BernardoVilaca/LiteCOPASAelevatoria/Testes&Resultados/FLUXOGRAMA_AUTOGERENCIAMENTO_ELEVATÓRIA.jpg

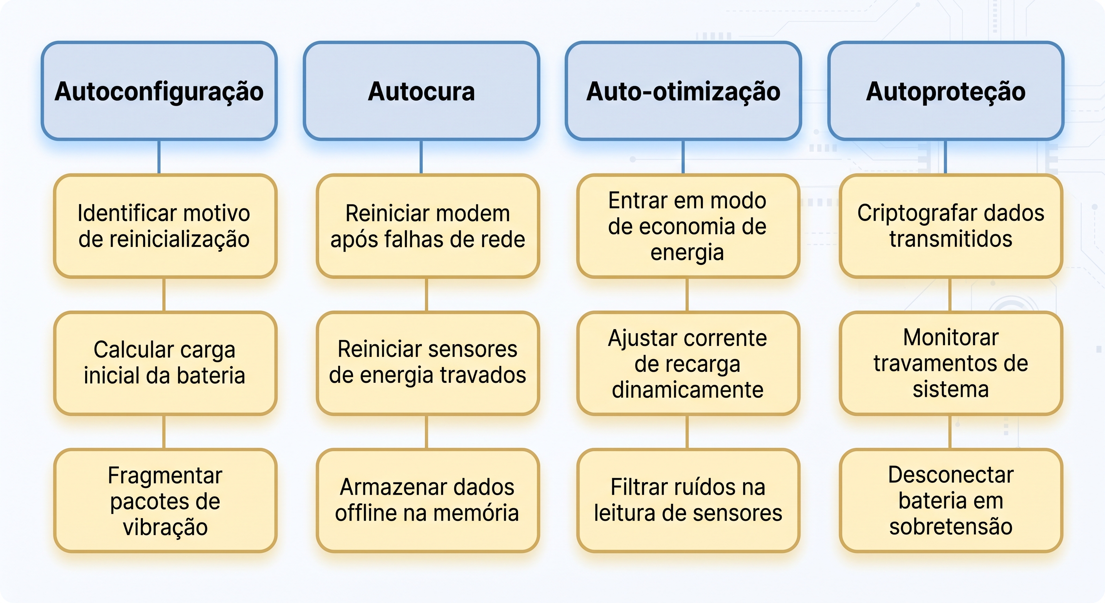
Testes&Resultados/FLUXOGRAMA_AUTOGERENCIAMENTO_ELEVATÓRIA.jpg
