BernardoVilaca/LiteCOPASAelevatoria/FonteCorrente_Para4a20Para0a3v3/CircuitoPressaoCopasaDesenhoBernardos.jpg

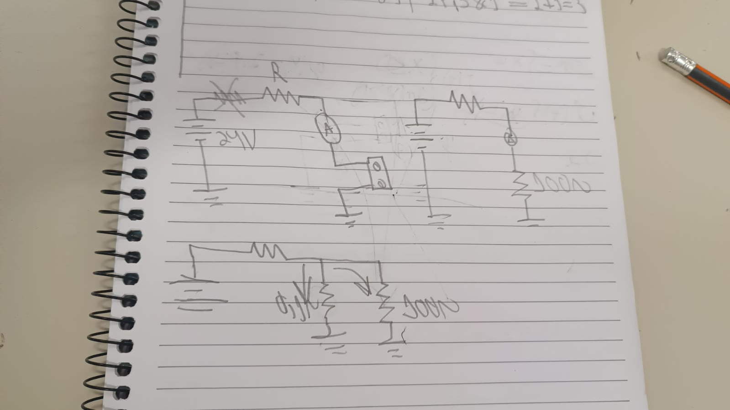
FonteCorrente_Para4a20Para0a3v3/CircuitoPressaoCopasaDesenhoBernardos.jpg
