BernardoVilaca/LiteCOPASAelevatoria/ReferênciasInternasLITE/Lab - Introdução_Metrologia_ESP32_2025.docx

Laboratório – Introdução à Metrologia Elétrica com o módulo potenciômetro e o ESP32

# Objetivos

Uso do Software Arduino IDE

Configuração do ESP32 no Arduino IDE

# Executar os procedimentos de metrologia elétrica com o módulo potenciômetro e o ESP32

# Histórico/Cenário

Os sensores que serão utilizados no projeto de desenvolvimento tecnológico devem apresentar medidas confiáveis, de modo que a base de dados gerada pelo sistema projetado possibilite a extração de conhecimento da planta também confiável! Nesta atividade, você executará os procedimentos de metrologia elétrica utilizando o módulo potenciômetro e o ESP32.

# Recursos necessários

- ESP32
- Um cabo USB para conexão ao PC
- Módulo potenciômetro de 10 kOhm
- Multímetro Fluke

# Estudo dos principais conceitos em metrologia elétrica para execução de correção de medidas elétricas

Etapa 1: Principais conceitos em metrologia elétrica

a. Descrição dos principais conceitos de metrologia elétrica disponíveis nas notas de aula em anexo (Fonte: PUC Goiás e o livro “Fundamentos de Metrologia Científica e Industrial”):
  1) Medir:
  2) Mensurando:
  3) Instrumento de medição:
  4) Indicação da medida:
  5) Indicação direta da medida e dê um exemplo:
  6) Processo de medição:
  7) Resultado da medição, sua equação e um exemplo numérico com uma régua:
  8) Resultado base:
  9) Incerteza da medição:
  10) Incerteza de medição do conversor A/D do ESP32:
b. Definição de erro sistemático, erro aleatório, tendência, correção e outros termos:
  1) Erro de medição e sua equação:
  2) Fontes de erros de medição:
  3) Erro sistemático e um exemplo:
  4) Erro aleatório e um exemplo:
  5) Exatidão:
  6) Precisão:
  7) Equação do erro sistemático:
  8) Tendência e sua equação:
  9) Correção e sua equação:
  10) Valor verdadeiro convencional:
  11) Indicação corrigida:
  12) Equação do erro aleatório:
  13) Repetitividade e sua equação para um número finito de amostras:
  14) Diferença entre erro e incerteza de medição:

Etapa 2: Cálculo de tendência e correção das medidas de tensão elétrica com o módulo potenciômetro e o ESP32

a. Definição do medidor de referência (especificações técnicas metrológicas do datasheet do multímetro Fluke) para a medição de tensão elétrica no módulo potenciômetro

R.

b. Utilize a prática “Lab - Introduction to Arduino_ADC_2025” e siga os procedimentos a seguir para realizar a correção das medidas de tensão realizadas na referida prática.
  1) Cálculo da tendência para as medidas da tabela da prática. Apresente as tabelas de medidas, conforme exemplo disponível na aula 2 em anexo. Cole a tela do monitor serial para cada uma das medidas de tensão do ESP32 (uma tela por tabela).

Valor ajustado no potenciômetro e medido com o Voltímetro (V) | Valor calculado pelo programa (Vax) [V]
0,50 V
0,50 V
0,50 V
0,50 V
0,50 V
0,50 V
0,50 V
0,50 V
0,50 V
0,50 V
0,50 V
0,50 V
Média:
Desvio-padrão:
Tendência (Td = I – VVC):
Correção (C):

Valor ajustado no potenciômetro e medido com o Voltímetro (V) | Valor calculado pelo programa (Vax) [V]
1,00 V
1,00 V
1,00 V
1,00 V
1,00 V
1,00 V
1,00 V
1,00 V
1,00 V
1,00 V
1,00 V
1,00 V
Média:
Desvio-padrão:
Tendência (Td = I – VVC):
Correção (C):

Valor ajustado no potenciômetro e medido com o Voltímetro (V) | Valor calculado pelo programa (Vax) [V]
1,50 V
1,50 V
1,50 V
1,50 V
1,50 V
1,50 V
1,50 V
1,50 V
1,50 V
1,50 V
1,50 V
1,50 V
Média:
Desvio-padrão:
Tendência (Td = I – VVC):
Correção (C):

Valor ajustado no potenciômetro e medido com o Voltímetro (V) | Valor calculado pelo programa (Vax) [V]
2,00 V
2,00 V
2,00 V
2,00 V
2,00 V
2,00 V
2,00 V
2,00 V
2,00 V
2,00 V
2,00 V
2,00 V
Média:
Desvio-padrão:
Tendência (Td = I – VVC):
Correção (C):

Valor ajustado no potenciômetro e medido com o Voltímetro (V) | Valor calculado pelo programa (Vax) [V]
2,50 V
2,50 V
2,50 V
2,50 V
2,50 V
2,50 V
2,50 V
2,50 V
2,50 V
2,50 V
2,50 V
2,50 V
Média:
Desvio-padrão:
Tendência (Td = I – VVC):
Correção (C):

Valor ajustado no potenciômetro e medido com o Voltímetro (V) | Valor calculado pelo programa (Vax) [V]
3,00 V
3,00 V
3,00 V
3,00 V
3,00 V
3,00 V
3,00 V
3,00 V
3,00 V
3,00 V
3,00 V
3,00 V
Média:
Desvio-padrão:
Tendência (Td = I – VVC):
Correção (C):

É possível fazer uma única correção para todos os valores medidos?

R.

  2) Cálculo da correção a ser inserida no programa de computador da prática.

R.

  3) Cálculo da estimativa da repetitividade (número finito de amostras) para 95,45% de probabilidade (Re = t.u).

R. v = ; t = ; u = ; Re = ; Faixa de valores = .

  4) Código Arduino da prática atualizado com a correção. Não se esqueça de comentar o código! Lembre-se: Código bonito é código comentado!!! Apresente o resultado ao monitor/professor!

R.

  5) Atualize o fluxograma da prática no drawio e cole-o aqui. Baixe o arquivo drawio, pois você deverá anexá-lo na NetAcad.

R.

© terça-feira, 22 de outubro de 2018 18:27:39 Cisco e/ou suas afiliadas. Todos os direitos reservados. Este documento contém informações públicas da Cisco. Página 2 de 6
