BernardoVilaca/LiteCOPASAelevatoria/ReferênciasInternasLITE/lab_-_levantamento_como_construído_caracterização_eletromagnética_2025.docx

Laboratório – Levantamento de “como construído” e caracterização eletromagnética utilizando o ESP32

# Objetivos

Uso do Software Arduino IDE

Configuração do ESP32 no Arduino IDE

# Levantamento de “como construído” e caracterização eletromagnética utilizando o ESP32

# Histórico/Cenário

O projeto de soluções de IoT demanda uma ou mais visitas técnicas à planta alvo com o intuito de realizar o levantamento do “como construído” e a caracterização eletromagnética da referida planta. Nesta atividade, faremos uma aula de campo na estufa do COLTEC, para realizar essas atividades importantes da fase de projeto.

# Recursos necessários

- ESP32
- Um cabo USB para conexão ao Notebook
- Instalação do aplicativo Cobertura no Smartphone
- Instalação do aplicativo InSSIDer no Notebook, se for o caso.

Instalação do Aplicativo Cobertura no Smartphone.

Acesse o Google Play e procure o aplicativo Cobertura e, em seguida, instale-o em seu smartphone.

Instalação do Aplicativo InSSIDer no notebook.

Acesse o link InSSIDer (https://www.metageek.com/downloads/inssider-win/), baixe o aplicativo InSSIDer e instale-o em seu notebook. Se preferir, o notebook do professor poderá ser utilizado.

Uso do Software Arduino IDE.

Nessa parte, você conectará a placa de desenvolvimento do ESP32 ao computador por meio da porta USB. Você usará um programa de exemplo para medir o RSSI (Indicador de Intensidade do Sinal Recebido) de uma rede de Wi-Fi do COLTEC.

# Etapa 1: Noções de modulação, ruído, decibel e aplicações práticas da Série de Fourier

1. Cite e defina cada um dos parâmetros de uma portadora senoidal que podem ser modificados pelo sinal modulante.

R.

2. Cite as vantagens de se utilizar a modulação?

R.

3. Defina ruído.

R.

4. Defina SNR. Apresente sua equação.

R

5. Determine a capacidade máxima de um canal telefônico de largura de banda de 4 kHz e SNR de 30 dB.

R.

6. Defina decibel.

R.

7. Quais os principais motivos para a utilização do decibel?

R.

8. Mostre as equações para o cálculo em decibéis para tensão e potência.

R.

9. Cite as regras básicas de operação com decibéis.

R.

10. O que diz a Série de Fourier e quais as consequências práticas?

R.

11. Defina espectro e forma de onda.

R.

12. Calcular o ganho, em dB, de um amplificador, que excitado com 1 W de sinal na entrada fornece 10 W na saída.

R.

13. Converter 13 dBW em dBm e dBμ.

R.

14. Converter 30 dBm em dBW e dBμ.

R.

15. Converter 45 dBμ em dBW e dBm.

R.

16. Se o cálculo de tensão em dB tiver como referência a tensão de 1 volt, o resultado será expresso em dBV. Os valores de submúltiplos mili e micro também dão origem ao dBm e ao dBμ (similar ao caso da potência). Assim, converta 40 dBV em dBm e dBμ.

R.

17. Considerando-se a definição de dBV da questão anterior, para se converter 20 dBV em dBm, qual deve ser o valor a ser adicionado a 20 dBV? E para termos o resultado em dBμ?

R.

18. Calcular a diferença entre os níveis de potência: -110 dBm e –70 dBm.

R.

19. Dois sinais de 20 dBW dão entrada num circuito somador. Calcular o valor na saída.

R.

20. O nível de sinal na antena receptora é –53 dBm e o nível de ruído –73 dBm. Determine a SNR.

R.

# Etapa 2: Indicador da Intensidade do Sinal Recebido (RSSI, em inglês)

a. Consulte o que é, para que serve e qual é a unidade de medida do RSSI na Internet (Dica: aula de revisão sobre dB – Aula2_2029, na página principal do curso, módulo 3).
1) O que é o RSSI?

R.

2) Para que serve o RSSI?

R.

3) Qual é a unidade de medida do RSSI?

R.

b. O que é o dBm e como ele é calculado?
1) O que é o dBm?

R.

2) Como o dBm é calculado?

R.

c. Quanto vale (-30) dBm em unidade de potência (mW)?

R.

d. Explique a diferença entre -30 dBm e 30 dB?

R.

# Etapa 2: Conecte a placa Arduino

a. Inicie o Arduino IDE.
b. Vá em “Ferramentas” e verifique se a placa “ESP Dev Module” está selecionada.
c. Conecte o cabo USB à placa ESP32 e à porta USB no PC. Um LED vermelho fica aceso para indicar que ele está ligado.
d. Vá em “Ferramentas” e verifique se, na opção “Porta”, uma COM foi selecionada. Caso contrário, selecione a porta COM correta.

Etapa 3: Execute o código de exemplo.

a. Use o programa abaixo de exemplo:

#include <WiFi.h>

const char* ssid = "WIFI-LITE"; /*Replace SSID of your network "Team SAM"*/

const char* password = "LITE@IOT"; /*Replace with Password of your Network "123456789"*/

int counter = 1; /*Samples counter*/

const int samples = 30; /*Number of measures*/

const int timer = 1500; /*Time among samples*/

void setup() {

Serial.begin(115200); /*Baud Rate for serial communication*/

initWiFi(); /*Initialize WiFi*/

}

void loop() {

if (counter <= samples){

Serial.print("Connected Network Signal Strength (RSSI): ");

Serial.print(WiFi.RSSI()); /*Print WiFi signal strength*/

Serial.println(" dBm"); /*Power unit*/

delay(timer);

counter++;

} else{

Serial.println();

Serial.println("Finalizar medição!!!");

delay(5000);

}

}

void initWiFi() {

WiFi.mode(WIFI_STA); /*Initialize ESP32 WiFi in station mode*/

WiFi.begin(ssid, password); /*Begin WiFi connection*/

Serial.print("Connecting to WiFi ..");

while (WiFi.status() != WL_CONNECTED) {

Serial.print('.');

delay(1000);

}

Serial.println();

Serial.print("Local IP address of ESP32: ");

Serial.println(WiFi.localIP()); /*Print local IP address of ESP32*/

}

d. Explique o funcionamento desse programa?

R.

e. Para verificar se a placa correta foi selecionada, clique em Ferramentas > Placa. Ela deve ser ESP32 Dev Module.
f. Antes de compilar o programa, acrescente comentários às suas linhas, de modo que ele fique inteligível para outros programadores (lembre-se: código bonito é código comentado!).
g. Clique em Sketch > Verificar/Compilar para compilar o programa.
h. Clique em Sketch > Carregar para carregar o código compilado na sua placa.
i. Mostre o resultado ao monitor/professor.
j. Usando os conhecimentos que você adquiriu na prática “Lab - Creating a Process Flowchart”, faça o fluxograma do programa no Draw IO e cole-o aqui. Não se esqueça de salvar o arquivo DrawIO para postar posteriormente na NetAcad.

R.

k. Peça o SSID e a senha da rede Wi-Fi disponível na estufa, substitua no código anterior e grave-o no ESP32. Você está pronto para ir a campo!!!

Etapa 4: Relatório de atividades.

l. Descrição do "como construído" da estufa e do córrego. Descrever as características da planta (estufa) analisada (ilustre com fotos) e relate:
  a as demandas de sensoriamento e atuação (ilustre com fotos):

R.

  b melhores pontos de medição (ilustre com fotos):

R.

  c pontos de energia disponíveis (ilustre com fotos):

R.

  d necessidade ou não de instalação de infraestrutura para instalação do sistema de monitoramento (ilustre com fotos):

R.

m. Descrição da caracterização eletromagnética realizada na estufa.
  a Descrever as informações obtidas com o aplicativo cobertura e o programa InSSIDer (ilustre com as fotos).

R.

  b Identificar as redes encontradas, tanto de Wi-Fi como de telefonia móvel e concluir tecnicamente as redes que poderiam ser utilizadas no sistema.

R.

n. Caracterização eletromagnética com o ESP32.
  a Descrever os pontos testados e apresentar uma tabela dos valores obtidos de RSSI, com a média e o desvio-padrão:

R.

RSSI (dBm)

Média:

Desvio-padrão:

  b Identifique os melhores pontos de medição, levando em conta o nível de sinal (RSSI), instalação física dos sensores e atuadores; e pontos de energia disponíveis (ilustre com fotos):

R.

© terça-feira, 22 de outubro de 2018 18:27:39 Cisco e/ou suas afiliadas. Todos os direitos reservados. Este documento contém informações públicas da Cisco. Página 7 de 7
