BernardoVilaca/LiteCOPASAelevatoria/FonteCorrente_Para4a20Para0a3v3/Documentação_a_mao_sensor_de_pressao_LITE_COPASA.pdf

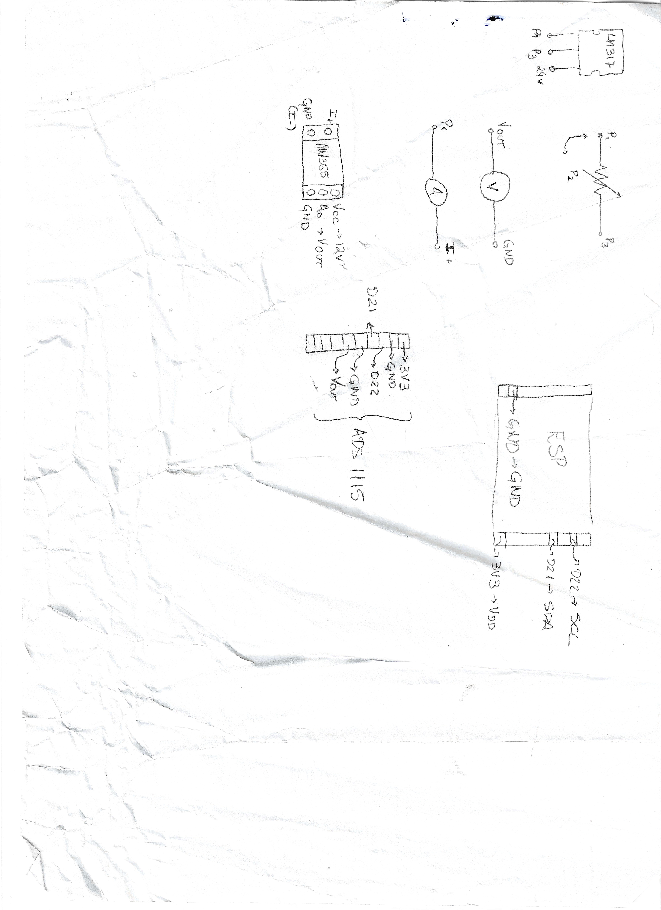
[picture p57: page 1]
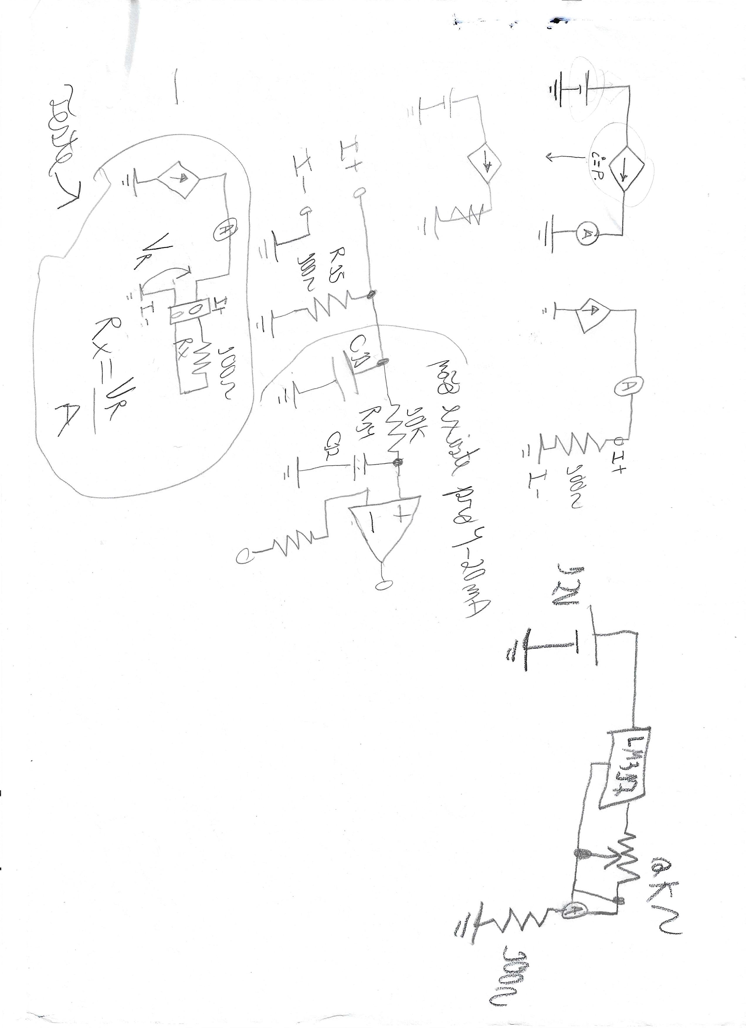
[picture p58: page 2]
