BernardoVilaca/LiteCOPASAelevatoria/FonteCorrente_Para4a20Para0a3v3/SistemaCopasaAlexadreDesenho.png

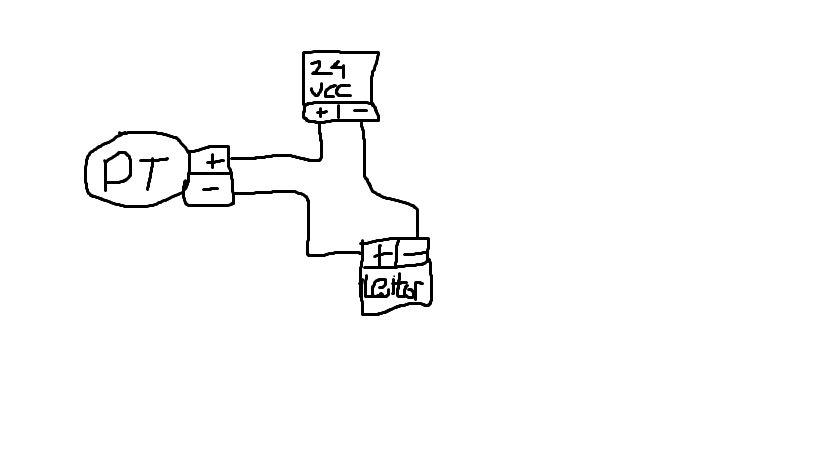
FonteCorrente_Para4a20Para0a3v3/SistemaCopasaAlexadreDesenho.png
