BernardoVilaca/LiteCOPASAelevatoria/FonteCorrente_Para4a20Para0a3v3/SistemaCopasaAlexadreDesenhoDesenhoCasamento.png

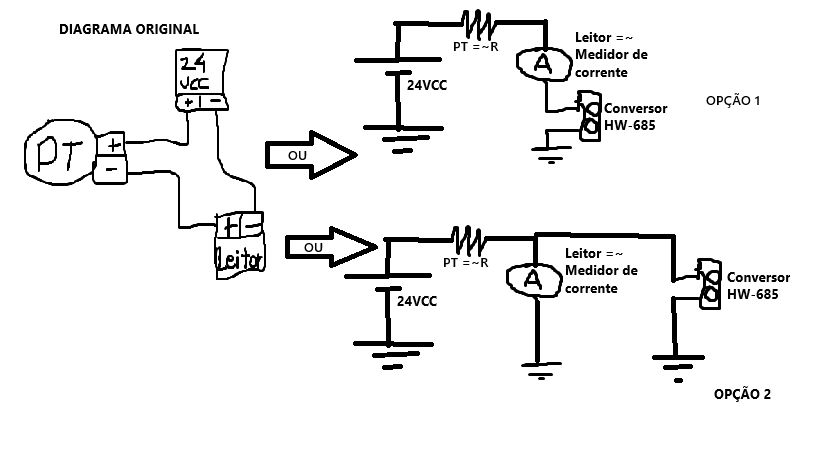
FonteCorrente_Para4a20Para0a3v3/SistemaCopasaAlexadreDesenhoDesenhoCasamento.png
