BernardoVilaca/LiteCOPASAelevatoria/Referências/PinagemEsp.png

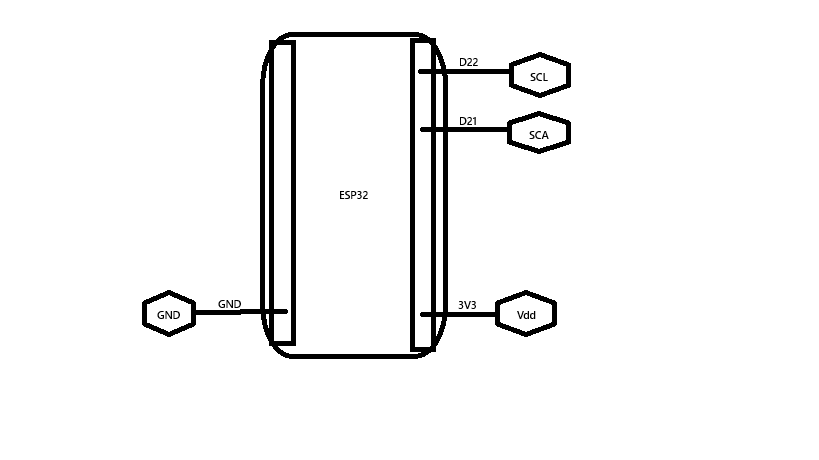
Referências/PinagemEsp.png
