BernardoVilaca/LiteCOPASAelevatoria/Testes&Resultados/ETIQUETAS_ELEVATORIA.pdf

GND

V+
__/ __ | GND | Va | GND | Va | GND | Va

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
SDA2

26
SCL2

27
PWM

14
EN
12 | 13 | GND

GND

15
SLEE
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
5V | GND | 5V | GND | GND | 3,3V | GND | 3,3V
SCL | SDA | 3,3V | Vo | 5V | GND | PWM | EN
Va | Va | GND | Vb | GND | GND
V+ | GND

GND

V+
__/ __ | GND | Va | GND | Va | GND | Va

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
SDA2

26
SCL2

27
PWM

14
EN
12 | 13 | GND

GND

15
SLEE
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
5V | GND | 5V | GND | GND | 3,3V | GND | 3,3V
SCL | SDA | 3,3V | Vo | 5V | GND | PWM | EN
Va | Va | GND | Vb | GND | GND
V+ | GND
