BernardoVilaca/LiteCOPASAelevatoria/Testes&Resultados/ETIQUETAS_LITE_COR.pdf

GND

V+ | GND | Va | GND | Va | GND | Va

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
25 | 26 | 27 | 14
12 | 13 | GND

GND

15
2

4 RX
16

TX
17
5 | 18 | 19
23

22
SCL

21
SDA
5V | GND | 5V | GND | GND | 3,3V | GND | 3,3V
SCL | SDA | 3,3V | Vo | 5V | GND | PWM | EN
Va | Va | GND | Vb | GND | GND
V+ | GND

GND

V+ | GND | Va | GND | Va | GND | Va

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
25 | 26 | 27 | 14
12 | 13 | GND

GND

15
2

4 RX
16

TX
17
5 | 18 | 19
23

22
SCL

21
SDA
5V | GND | 5V | GND | GND | 3,3V | GND | 3,3V
SCL | SDA | 3,3V | Vo | 5V | GND | PWM | EN
Va | Va | GND | Vb | GND | GND
V+ | GND

GND

V+ | GND | Va | GND | Va | GND | Va

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
25 | 26 | 27 | 14
12 | 13 | GND

GND

15
2

4 RX
16

TX
17
5 | 18 | 19
23

22
SCL

21
SDA
5V | GND | 5V | GND | GND | 3,3V | GND | 3,3V
SCL | SDA | 3,3V | Vo | 5V | GND | PWM | EN
Va | Va | GND | Vb | GND | GND
V+ | GND

GND

V+ | GND | Va | GND | Va | GND | Va

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
25 | 26 | 27 | 14
12 | 13 | GND

GND

15
2

4 RX
16

TX
17
5 | 18 | 19
23

22
SCL

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

GND

V+ | GND | Va | GND | Va | GND | Va

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
25 | 26 | 27 | 14
12 | 13 | GND

GND

15
2

4 RX
16

TX
17
5 | 18 | 19
23

22
SCL

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

GND

V+ | GND | Va | GND | Va | GND | Va

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
25 | 26 | 27 | 14
12 | 13 | GND

GND

15
2

4 RX
16

TX
17
5 | 18 | 19
23

22
SCL

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

GND

V+ | GND | Va | GND | Va | GND | Va

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
25 | 26 | 27 | 14
12 | 13 | GND

GND

15
2

4 RX
16

TX
17
5 | 18 | 19
23

22
SCL

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

GND

V+ | GND | Va | GND | Va | GND | Va

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
25 | 26 | 27 | 14
12 | 13 | GND

GND

15
2

4 RX
16

TX
17
5 | 18 | 19
23

22
SCL

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
