BernardoVilaca/LiteCOPASAelevatoria/Testes&Resultados/Protótipo_para_análise_vibracional_de_motores.pdf

## Relatório de Protótipo para Monitoramento de Vibração em Máquinas Rotativas

Felipe Augusto Ramos Diniz

9 de outubro de 2025

## 1 Introdução

O monitoramento de vibrações é uma técnica consolidada na manutenção preditiva de equipamentos industriais, como conjuntos moto-bomba. A análise dos sinais vibratórios permite detectar alterações no comportamento dinâmico de uma máquina, possibilitando a identificação de falhas, como desbalanceamento, desalinhamento e desgaste em rolamentos. Conforme demonstrado por diversos autores, a análise do espectro de frequência via Transformada Rápida de Fourier (FFT) é uma metodologia eficaz para decompor os sinais complexos de vibração e identificar suas frequências características. Tradicionalmente, sistemas de monitoramento industrial envolvem alto custo de instrumentação. Este projeto, no entanto, explora a viabilidade de um protótipo de baixo custo, utilizando um microcontrolador ESP32 e um acelerômetro ADXL345. A abordagem é similar à de de outros estudos que validaram o uso de plataformas como Arduino e sensores para o diagnóstico de falhas de baixa frequência em equipamentos reais. Este relatório detalha a metodologia de desenvolvimento e validação do protótipo, utilizando um celular como fonte de vibração controlada para simular a assinatura espectral de uma máquina rotativa.

## 2 Componentes e Justificativas

- Microcontrolador ESP32 WROOM-32: Escolhido por seu baixo custo e disponibilidade no laboratório.
- Acelerômetro ADXL345: Um sensor MEMS triaxial de baixo consumo, com saída digital e interface de comunicação I2C/SPI. Sua taxa de amostragem configurável (até 3200 Hz) e processamento de sinal embarcado o tornam adequado para a captura de sinais vibratórios dinâmicos.
- Celular (iPhone 11): Utilizado como gerador de sinais de referência, produzindo vibrações em frequências específicas por meio de de um aplicativo gerador de tons.
- Software: Arduino IDE para o firmware do ESP32, Python 3 com as bibliotecas Pandas, NumPy e Matplotlib para coleta e análise de dados no computador.

## 3 Metodologia

A validação do protótipo foi realizada por meio de testes com frequências controladas, geradas pelo aplicativo Frequency: Sound Generator. A metodologia foi dividida em setup experimental, aquisição e processamento dos sinais.

### 3.1 Setup Experimental

O acelerômetro foi acoplado fisicamente à carcaça do celular. Testes iniciais revelaram que o posicionamento do sensor é crítico para a qualidade do sinal, um fato também observado em manuais de boas práticas. A melhor resposta foi obtida quando o sensor foi fixado firmemente com fita dupla-face sobre a principal fonte de vibração do celular (o alto-falante). A montagem final pode ser vista na Figura 1.

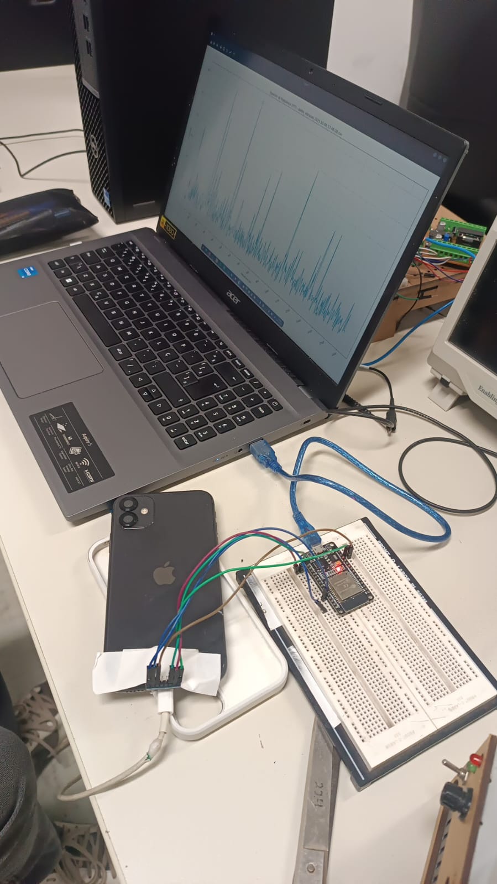
[picture p74: figure]

Figura 1: Montagem do sensor ADXL345 acoplado ao celular para o teste.

### 3.2 Aquisição e Processamento de Sinais

O ESP32 foi configurado para operar como um coletor de dados de alta velocidade. Para evitar problemas de sincronização intermitentes, foi implementado um protocolo de "handshake", onde o script em Python aguarda uma mensagem de prontidão do ESP32 antes de enviar um comando para iniciar a coleta.
O sensor foi configurado para uma taxa de amostragem de 3200 Hz, respeitando o Teorema de Nyquist-Shannon para analisar frequências de até 1600 Hz, faixa que abrange os principais fenômenos vibratórios em muitos motores industriais. O processo segue os seguintes passos:

1. Ao receber um comando via serial, o ESP32 coleta um bloco de 1024 amostras dos 3 eixos do acelerômetro, armazenando-as em um buffer interno.
2. O bloco de dados é transmitido em formato binário para um script em Python.
3. O script desempacota os bytes, converte os valores para aceleração (m/s²
) e os
armazena em um arquivo CSV com timestamps de alta resolução.
4. Um segundo script Python carrega o arquivo CSV e aplica a Transformada Rápida de Fourier (FFT) para gerar o espectro de frequência do sinal.

## 4 Resultados e Discussão

A validação do protótipo, apesar de sua natureza rudimentar, confirmou a eficácia da metodologia de aquisição e análise de vibrações. Um dos aprendizados mais significativos foi a importância crítica do posicionamento e acoplamento do sensor, um ponto enfatizado em manuais de boas práticas de medição de vibração. A diferença entre um acoplamento mecânico inadequado e um otimizado é demonstrada visualmente nos testes a seguir.

### 4.1 Análise do Sinal de 30 Hz

No primeiro teste, foi gerado um sinal de 30 Hz. A Figura 4 compara o espectro de frequência obtido com o sensor posicionado no centro da carcaça do celular versus posicionado diretamente sobre a fonte sonora.

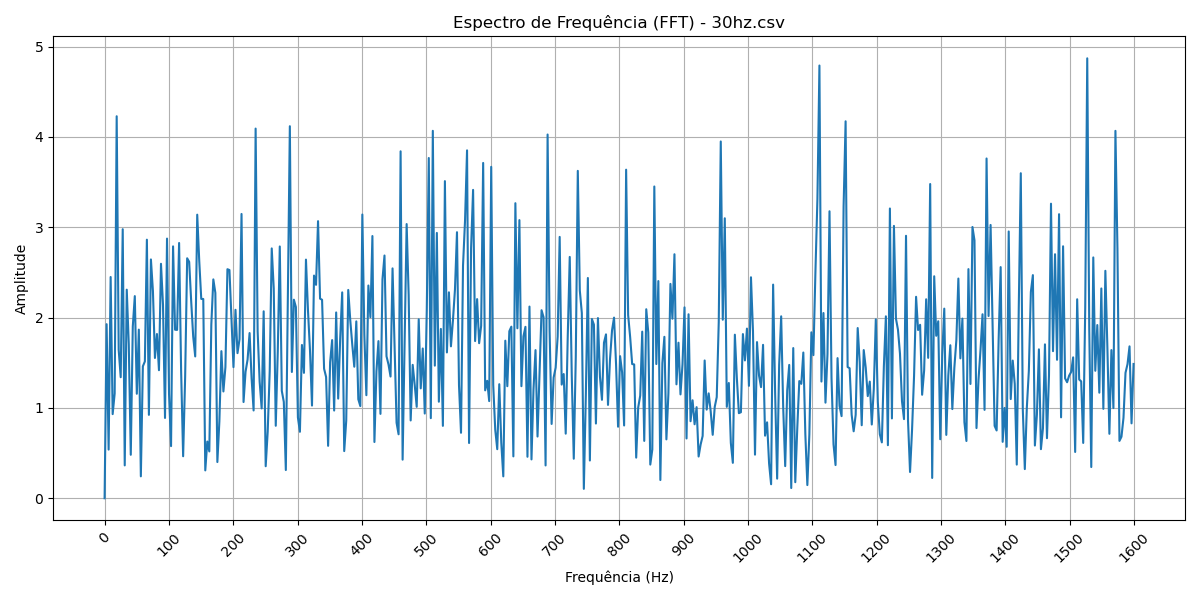
[picture p75: figure]

Figura 2: *
(a) Espectro inicial (ruidoso)

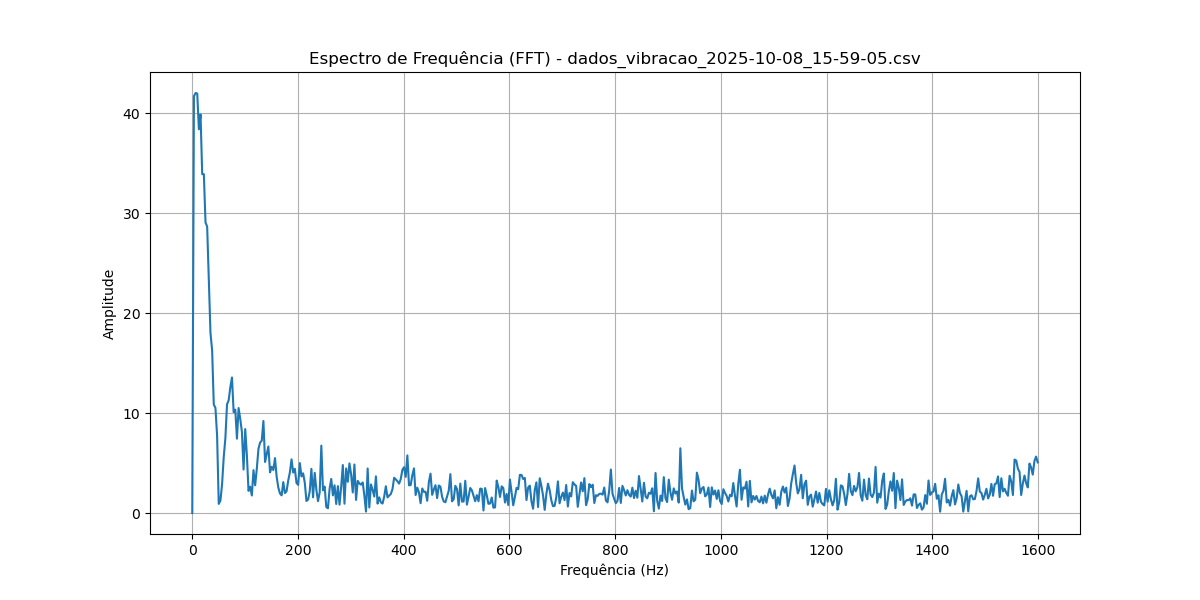
[picture p76: figure]

Figura 3: *
(b) Espectro otimizado

Figura 4: Comparação do espectro para um sinal de 30 Hz. Em (a), o sinal com alto ruído obtido com o sensor no centro da carcaça. Em (b), o espectro claro com um pico fundamental dominante em 30 Hz, obtido após o reposicionamento do sensor.

Como se pode observar, o espectro inicial (a) é dominado por ruído, tornando a identificação da frequência de 30 Hz ambígua. Após otimizar o posicionamento para garantir um melhor acoplamento mecânico, o espectro resultante (b) mostra um pico nítido e de alta amplitude exatamente na frequência de interesse, validando a capacidade de detecção do sistema.

### 4.2 Análise do Sinal de 440 Hz

O mesmo procedimento foi repetido para um sinal de 440 Hz (Figura 7), que revelou um cenário ainda mais rico.

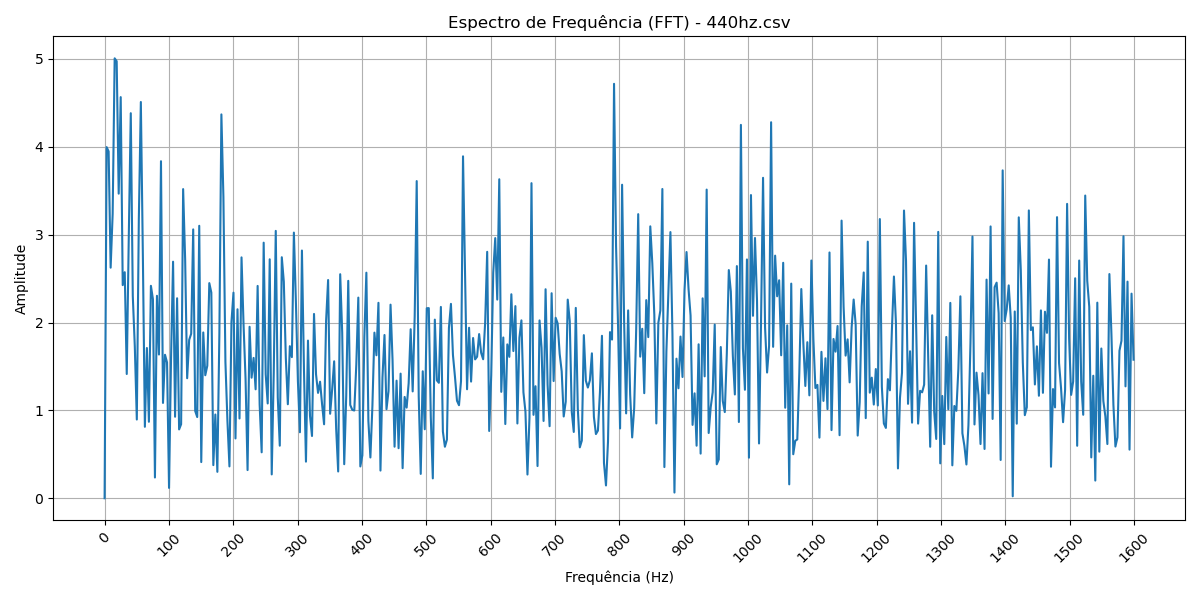
[picture p77: figure]

Figura 5: *
(a) Espectro inicial (ruidoso)

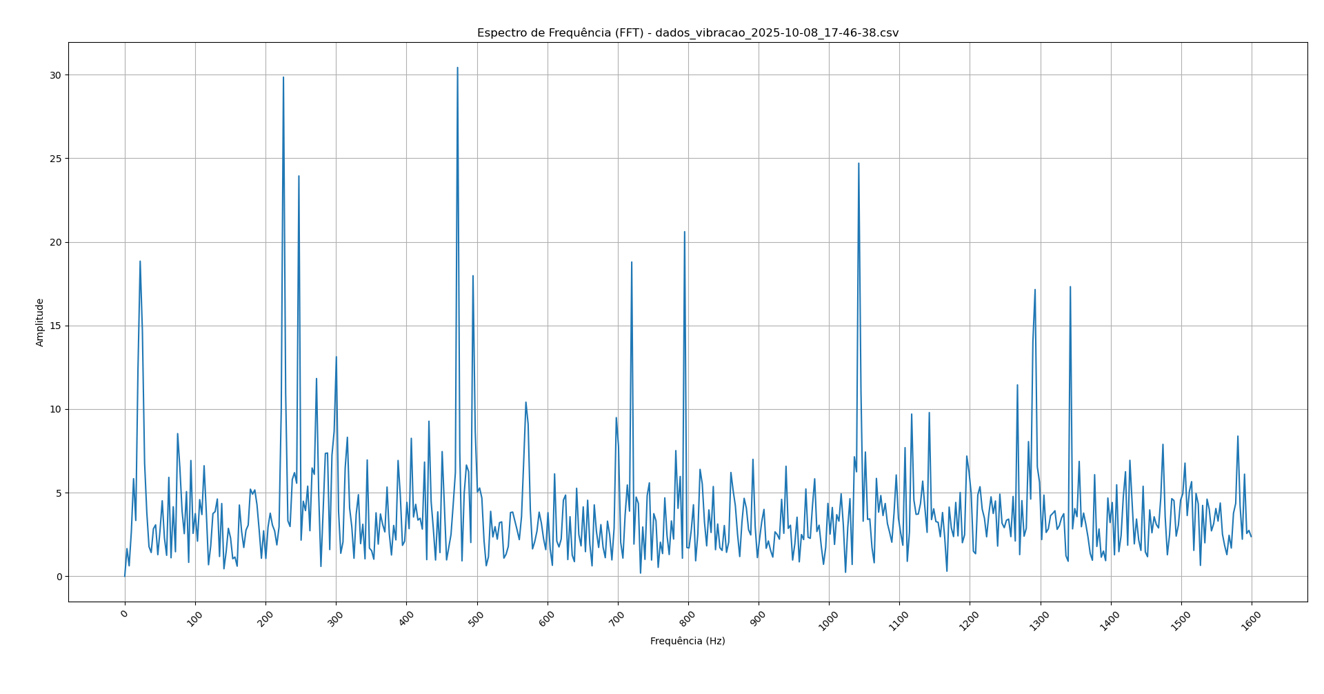
[picture p78: figure]

Figura 6: *
(b) Espectro otimizado

Figura 7: Comparação do espectro para um sinal de 440 Hz. Em (a), o sinal ruidoso onde a frequência fundamental é indistinguível. Em (b), a clara identificação do pico em 440 Hz e de outros fenômenos secundários.

Novamente, o resultado inicial (a) foi inconclusivo. No entanto, o espectro otimizado
(b) não apenas identificou o pico fundamental em 440 Hz, mas também outros fenômenos complexos. Foram claramente identificados picos nos múltiplos inteiros de 880 Hz (2f) e 1320 Hz (3f), que são os harmônicos da frequência fundamental. A análise de harmônicos é uma ferramenta padrão para diagnóstico de desalinhamento e folgas mecânicas em máquinas reais. Adicionalmente, o pico em ≈220 Hz (f/2) é característico de uma resposta não-linear do sistema mecânico, demonstrando a sensibilidade do protótipo a comportamentos dinâmicos complexos.
Talvez a descoberta mais relevante tenha sido a observação do fenômeno da ressonância, onde a vibração de entrada excita frequências naturais da estrutura em pontos de maior energia. Este fenômeno é precisamente o princípio chave utilizado para detectar falhas em rolamentos em estágios iniciais, conforme descrito na literatura. Os impactos de um rolamento defeituoso (evento de baixa frequência) são fracos, mas a ressonância estrutural que eles excitam em alta frequência é um indicador claro e de alta energia, facilmente detectável por uma análise de FFT.
As principais limitações do protótipo residem na sua montagem improvisada. No entanto, como ferramenta de validação, o sistema demonstrou com sucesso que a combinação do ESP32 com o ADXL345 é adequada para capturar e processar sinais vibratórios complexos, fornecendo uma base sólida para a aplicação da metodologia em motores elétricos reais.

## 5 Conclusão

O protótipo desenvolvido demonstrou ser uma ferramenta viável e de baixo custo para a aquisição e análise espectral de sinais vibratórios. Os testes confirmaram a capacidade do sistema em identificar com precisão frequências fundamentais, harmônicos e ressonâncias, validando a metodologia para futuras aplicações em equipamentos reais. O projeto corrobora as conclusões de outros estudos sobre a eficácia de sistemas baseados em microcontroladores e sensores MEMS para tarefas de manutenção preditiva.
O próximo passo é a aplicação desta ferramenta validada no conjunto motor-bomba real para capturar sua assinatura espectral em operação normal e monitorar a evolução de seus picos de frequência ao longo do tempo.

## Referências

[1] F. J. da Silva, Manutenção Preditiva por Análise de Vibração com Utilização de Microcontrolador Arduino e Sensor MEMS: Estudo de Caso de um Conjunto Moto-Bomba. Trabalho de Conclusão de Curso, Universidade Federal da Grande Dourados, 2022.
[2] R. F. M. Marçal e A. A. Susin, "Detectando Falhas Incipientes Em Máquinas Rotativas,"Revista Gestão Industrial, vol. 01, n. 02, pp. 83–92, 2005.
[3] V. C. P. da Silva, O Emprego do Acelerômetro ADXL345 para a Obtenção da Aceleração, Velocidade e Deslocamento no Eixo XY. Trabalho de Conclusão de Curso, Universidade de São Paulo, 2018.

## A Anexo A: Código Arduino IDE (Coleta de Dados no ESP32)

1 | # include < Wire .h >
2 | # include < Adafruit_Sensor .h >
3 | # include < Adafruit_ADXL345_U .h >
4 | # include " rtc_wdt .h"
5 | Adafruit_ADXL345_Unified accel = Adafruit_ADXL345_Unified () ;
6 | # define NUM_AMOSTRAS 1024
7 | struct AmostraAcelerometro {
8 | int16_t x ;
9 | int16_t y ;
10 | int16_t z ;
11 | };
12 | AmostraAcelerometro bufferDeAmostras [ NUM_AMOSTRAS ];

13
14 | void setup () {
15 | Serial . begin (115200) ;
16 | delay (2000) ; // Pausa para e s t a b i l i z a | | o

17
18 | if (! accel . begin () ) {
19 | Serial . println (" ADXL345 nao detectado !");
20 | while (1) ; // Trava aqui se o sensor | n | o for encontrado
21 | }
22 | accel . setDataRate ( ADXL345_DATARATE_3200_HZ ) ;
23 | accel . setRange ( ADXL345_RANGE_16_G );

24
25 | Serial . println (" Iniciando coleta c o n t | | n u a ... ");
26 | }

27
28 | void loop () {
29 | // --- Coleta ---
30 | for ( int i = 0; i < NUM_AMOSTRAS ; i ++) {
31 | sensors_event_t event ;
32 | accel . getEvent (& event );
33 | bufferDeAmostras [i ]. x = event . acceleration .x * 100;
34 | bufferDeAmostras [i ]. y = event . acceleration .y * 100;
35 | bufferDeAmostras [i ]. z = event . acceleration .z * 100;
36 | if (i % 100 == 0) rtc_wdt_feed () ;

37 | }

38
39 | // --- Envio ---
40 | for ( int i = 0; i < NUM_AMOSTRAS ; i ++) {
41 | while ( Serial . availableForWrite () < sizeof ( AmostraAcelerometro )
) {
42 | delay (1) ;
43 | }
44 | Serial . write (( uint8_t *) & bufferDeAmostras [i] , sizeof (
| AmostraAcelerometro ) );
45 | }

46
47 | delay (1000) ; // Pausa de 1 segundo antes de coletar o p r | x i m o
| bloco
48 | }

## B Anexo B: Código Python para Recebimento e Armazenamento

1 | import serial
2 | import struct
3 | import time
4 | import csv
5 | from datetime import datetime , timedelta

6
7 | # --- C o n f i g u r a | e s ---
8 | PORTA_SERIAL = ’/dev / ttyACM0 ’
9 | VELOCIDADE_SERIAL = 115200
10 | NUM_AMOSTRAS = 1024
11 | TAXA_SENSOR_HZ = 3200.0 # Taxa de amostragem configurada no ESP32

12
13 | # Cria um nome de arquivo | nico | com a data e hora atuais
14 | nome_arquivo = f" dados_vibracao_ { datetime . now (). strftime ( ’%Y -%m -% d_
| %H -%M -%S ’)}. csv "

15
16 | print (" --- INICIANDO LOGGER DE DADOS ---")
17 | try :
18 | # Abre a porta serial com timeout longo e sem reset DTR
19 | ser = serial . Serial ( PORTA_SERIAL , VELOCIDADE_SERIAL , timeout
| =20 , dsrdtr = False )
20 | print (f" Porta { PORTA_SERIAL } aberta . Aguardando o ESP32
estabilizar (3 segundos ) ... ")
21 | time . sleep (3)
22 | ser . reset_input_buffer () # Limpa qualquer dado antigo

23
24 | print (" Aguardando o p r x i m o bloco de dados do ESP32 ... ")
25 | bytes_esperados = NUM_AMOSTRAS * 3 * 2 # 1024 amostras * 3
| eixos * 2 bytes / eixo
26 | dados_binarios = ser . read ( bytes_esperados )

27 print (f" Leitura finalizada . Recebidos { len ( dados_binarios )} de { bytes_esperados } bytes .")

# Se a leitura foi bem - sucedida , processa e salva os dados

if len ( dados_binarios ) == bytes_esperados :
print (" SUCESSO ! Processando e salvando os dados no CSV ... ")

# Desempacota o bloco de bytes para uma lista de n m e r o s formato_struct = ’<’ + (’hhh ’ * NUM_AMOSTRAS ) # ’<’ para little - endian

valores_desempacotados = struct . unpack ( formato_struct , dados_binarios )

# Calcula o pequeno intervalo de tempo entre cada amostra delta_por_amostra = timedelta ( seconds =1/ TAXA_SENSOR_HZ ) timestamp_atual = datetime . now ()

# Abre o arquivo CSV para escrita

with open ( nome_arquivo , ’w’, newline =’’) as f :
writer = csv . writer ( f)
writer . writerow ([ ’timestamp ’, ’x_accel ’, ’y_accel ’, ’ z_accel ’])

# Escreve cada amostra no arquivo com um timestamp preciso

for i in range ( NUM_AMOSTRAS ) :
idx = i * 3
x = valores_desempacotados [ idx ] / 100.0 y = valores_desempacotados [ idx +1] / 100.0 z = valores_desempacotados [ idx +2] / 100.0

timestamp_linha = timestamp_atual + (i * delta_por_amostra )
writer . writerow ([ timestamp_linha . isoformat () , x , y , z ])

print (f" Dados salvos com sucesso em { nome_arquivo }")
else :
print (" FALHA . O bloco de dados n o foi recebido . Verifique o cabo e as c o n e x e s f s i c a s .")

except Exception as e :
print (f" Ocorreu um erro : {e}") finally :
if ’ser ’ in locals () and ser . is_open : ser . close ()
print (" C o n e x o serial fechada .")

## C Anexo C: Código Python para Análise FFT

import pandas as pd
import numpy as np

3 | import matplotlib . pyplot as plt
4 | import glob
5 | import os

6
7 | def analisar_vibracao ( nome_arquivo_csv ) :
8 | """
9 | Carrega dados de v i b r a | o , calcula a FFT , plota o espectro e
imprime a f r e q u n c i a fundamental .
10 | """
11 | try:
12 | print (f"\ nCarregando e analisando ’{ nome_arquivo_csv } ’...")
13 | df = pd . read_csv ( nome_arquivo_csv )
14 | sinal = df [’z_accel ’]. values

15
16 | df [’timestamp ’] = pd . to_datetime ( df [’timestamp ’])
17 | intervalo_tempo = df [’timestamp ’]. diff () . mean () .
total_seconds ()
18 | taxa_amostragem = 1 / intervalo_tempo
19 | print (f" Taxa de amostragem calculada : { taxa_amostragem :.2 f}
| Hz")

20
21 | N = len ( sinal )
22 | sinal_normalizado = sinal - np . mean ( sinal )

23
24 | yf = np . fft . fft ( sinal_normalizado )
25 | xf = np . fft . fftfreq (N , 1 / taxa_amostragem )

26
27 | # --- NOVO : Encontra e imprime a f r e q u n c i a fundamental

28
29 | # Pegamos as amplitudes e f r e q u n c i a s correspondentes (
apenas a parte positiva )
30 | # Ignoramos o | ndice | 0, que | o componente DC (
f r e q u n c i a zero )
31 | amplitudes = 2.0/ N * np . abs ( yf [1: N //2])
32 | frequencias = xf [1: N //2]

33
34 | # Encontra o | ndice | da maior amplitude
35 | indice_pico = np . argmax ( amplitudes )

36
37 | # Pega a f r e q u n c i a e a amplitude correspondentes a esse
| ndice
38 | frequencia_fundamental = frequencias [ indice_pico ]
39 | amplitude_pico = amplitudes [ indice_pico ]

40
41 | print ("\n--- A n l i s e de F r e q u n c i a ---")
42 | print (f" F r e q u n c i a Fundamental ( Pico Principal ): {
frequencia_fundamental :.2 f} Hz")
43 | print (f" Amplitude do Pico : { amplitude_pico :.2 f}")
44 | print (" ---------------------------------")

45
46 | # --- P r e p a r a | o e E x i b i | o do G r f i c o ---
47 | plt . figure ( figsize =(12 , 6) )

plt . plot ( frequencias , amplitudes ) # Usando as v a r i v e i s que j criamos

plt . title (f’Espectro de F r e q u n c i a ( FFT ) - {os. path . basename ( nome_arquivo_csv )}’)
plt . xlabel (’ F r e q u n c i a (Hz)’)
plt . ylabel (’Amplitude ’)
plt . grid ( True )

# Marca o pico fundamental no g r f i c o para f c i l

i d e n t i f i c a o
plt . plot ( frequencia_fundamental , amplitude_pico , "x", markersize =10 , label = f" Pico em { frequencia_fundamental :.2 f} Hz")
plt . legend ()

max_frequencia = taxa_amostragem / 2
ticks = np . arange (0 , max_frequencia + 1, 100) plt . xticks ( ticks , rotation =45)

plt . tight_layout ()
plt . show ()

except Exception as e:
print (f" Ocorreu um erro durante a a n l i s e : {e}")

if __name__ == " __main__ ":

arquivos_csv = glob . glob (’*. csv ’)

if not arquivos_csv :
print (" Nenhum arquivo . csv encontrado nesta pasta .") else :
print (" Arquivos CSV encontrados :")
for i , nome_arquivo in enumerate ( arquivos_csv ):
80 | print ( f" | [{i +1}] { nome_arquivo }")

try :

escolha = int ( input ("\ nDigite o n m e r o do arquivo que deseja analisar : "))

if 1 <= escolha <= len ( arquivos_csv ): arquivo_selecionado = arquivos_csv [ escolha - 1] analisar_vibracao ( arquivo_selecionado )
| else :
print (" Escolha i n v l i d a .")
except ValueError :
print (" Entrada i n v l i d a . Por favor , digite um n m e r o .
| ")
