BernardoVilaca/LiteCOPASAelevatoria/Testes&Resultados/teste_temperatura.pdf

## Relatório Técnico de Teste dos Sensores de

## Temperatura - Elevatória Morro dos Pintos

Integração de Monitoramento Térmico ao Sistema IoT LITE

Benardo Batista Vilaça & Felipe Ramos Diniz

2 de fevereiro de 2026

## 1 Caracterização do Cenário e Restrições

O monitoramento térmico é essencial para garantir a integridade operacional da Eleva-

tória Morro dos Pintos. A Figura 1 apresenta o diagrama de montagem utilizando o

microcontrolador ESP32 e o módulo MAX6675.

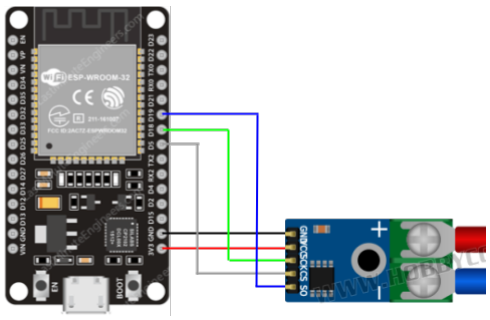
[picture p79: figure]

Figura 1: Diagrama de ligações entre ESP32 e MAX6675

Para a validação dos sensores, foi realizado um teste prático utilizando água em ebu-

lição (Figura 2). Devido à altitude de Belo Horizonte (aprox. 835m), o ponto de ebulição

esperado é inferior a 100°C.

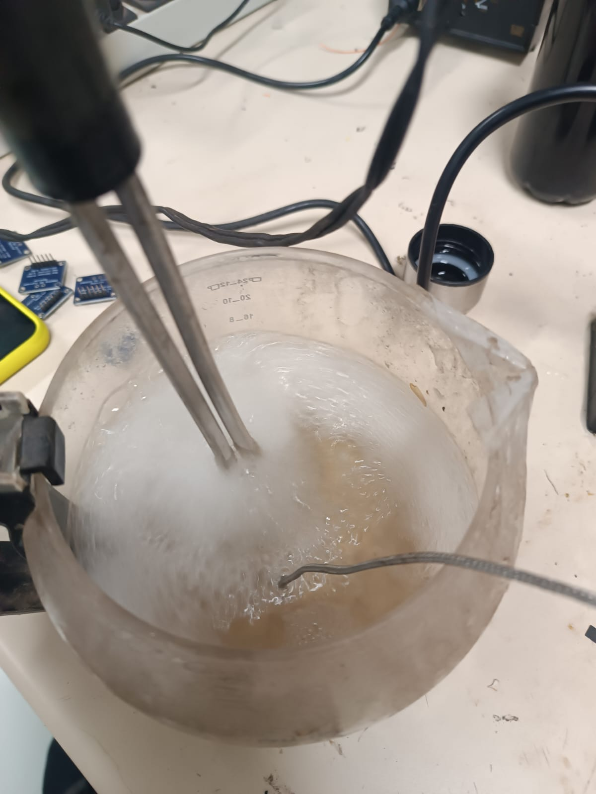
[picture p80: figure]

Figura 2: Teste com água em ebulição - Belo Horizonte, MG

## 2 Implementação do Firmware

O firmware foi desenvolvido em ambiente Arduino IDE para realizar a leitura serial do

termopar via interface SPI emulada.

Listing 1: Código para leitura do sensor MAX6675 com ESP32/Arduino

1 # include " max6675 .h"

2

3 | // Definicao dos pinos conforme montagem
4 | int thermoSO = 19; | // Fio Azul
5 | int thermoCS = 5; | // Fio Cinza
6 | int thermoSCK = 18; // Fio Verde

7

8 MAX6675 thermocouple ( thermoSCK , thermoCS , thermoSO );

9

10 | void setup () {
11 | Serial . begin (115200) ;

12 | Serial . println (" --- Teste de Termopar MAX6675 ---");
13 | delay (500) ;
14 | }

15

16 | void loop () {
17 | float celsius = thermocouple . readCelsius () ;

18

19 | if ( isnan ( celsius )) {
20 | Serial . println (" Erro na leitura do termopar !");
21 | } else {
22 | Serial . print (" Temperatura : ") ;
23 | Serial . print ( celsius ) ;
24 | Serial . println ("C") ;
25 | }
26 | delay (1000) ;
27 | }

## 3 Resultados e Coleta de Dados

A Tabela 1 apresenta os dados coletados durante o experimento. Observa-se a estabilidade

das leituras na faixa de 97°C, condizente com as condições atmosféricas locais.

Tabela 1: Leituras de Temperatura do Sensor MAX6675 - Monitoramento em Tempo Real
Timestamp | Temperatura (◦C)
18:42:31.122 | 97,25
18:42:32.152 | 97,25
18:42:33.148 | 97,00
18:42:34.129 | 97,00
18:42:35.134 | 97,50
18:42:36.115 | 97,50
18:42:37.140 | 97,50
18:42:38.152 | 97,50
18:42:39.112 | 97,25
18:48:10.145 | 96,75
18:48:11.104 | 97,00
18:48:12.107 | 97,25
18:48:13.112 | 97,00
18:48:14.131 | 97,25
18:48:15.129 | 97,25
18:48:16.124 | 97,25
