BernardoVilaca/LiteCOPASAelevatoria/Testes&Resultados/FLUXOGRAMA_ALTO_NÍVEL_NODERED_ELEVATORIA.pdf

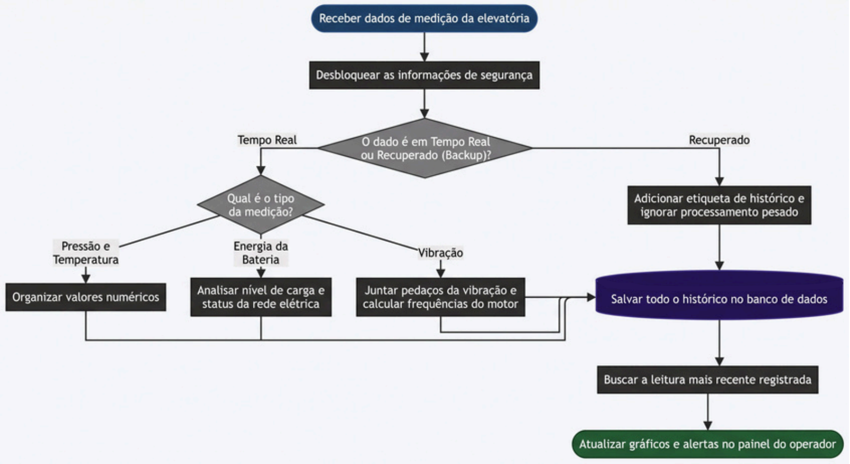
[picture p81: page 1]
