BernardoVilaca/LiteCOPASAelevatoria/Testes&Resultados/FLUXOGRAMA_GERAL_SIMPLIFICADO (2).pdf

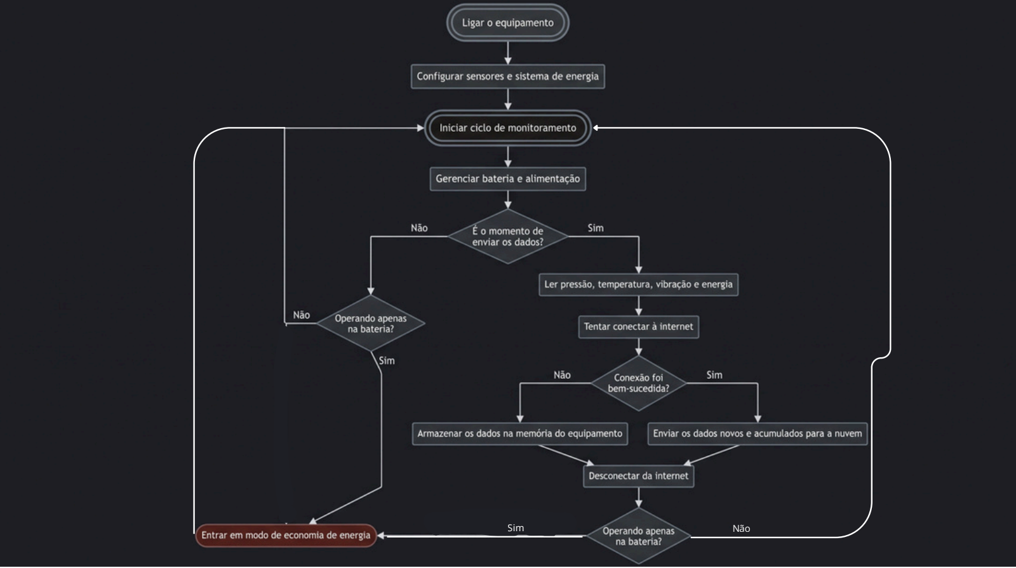
[picture p82: page 1]

Sim | Não
