BernardoVilaca/LiteCOPASAelevatoria/Testes&Resultados/FLUXOGRAMA_ELEVATÓRIA_TECNICO.jpg

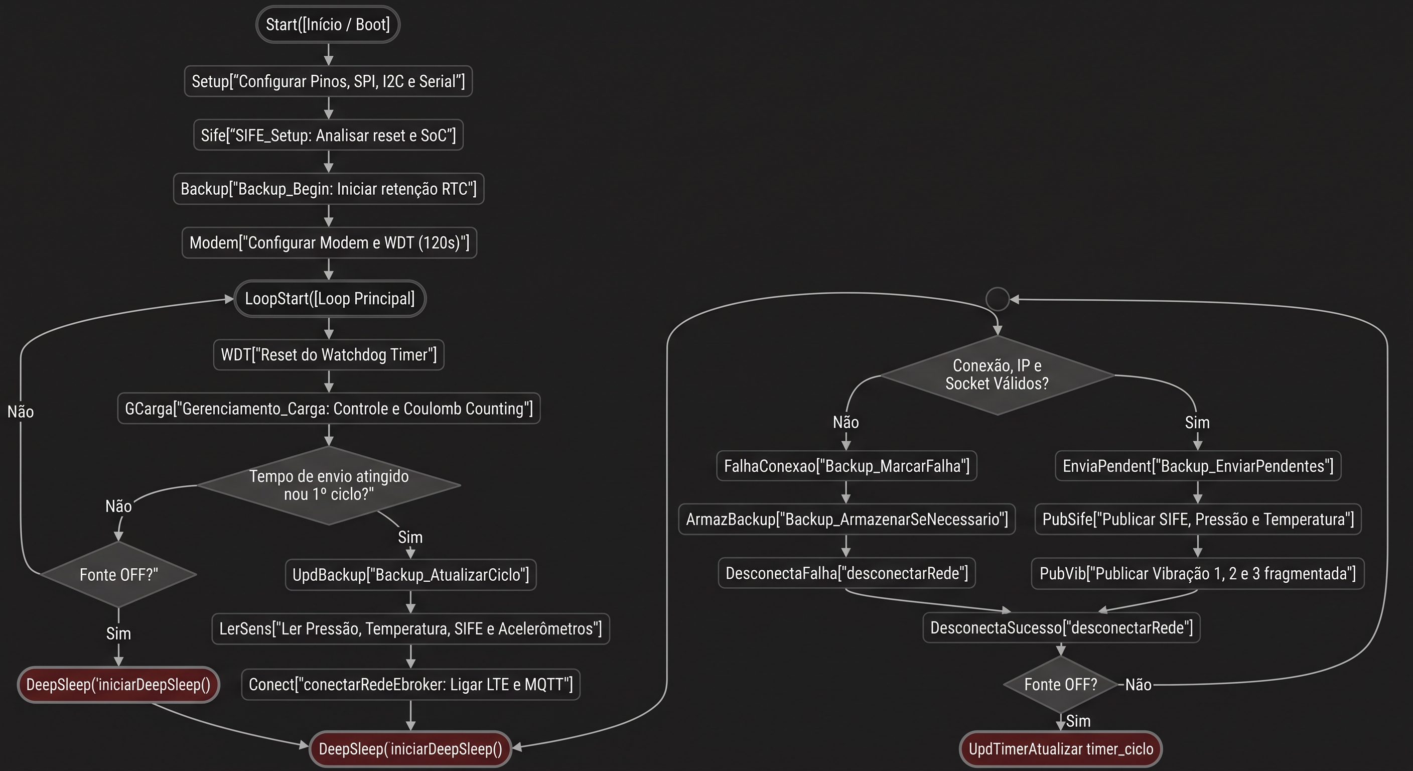
Testes&Resultados/FLUXOGRAMA_ELEVATÓRIA_TECNICO.jpg
