BernardoVilaca/LiteCOPASAelevatoria/Testes&Resultados/ESQUEMATICO_HARDWARE_ELEVATÓRIA.pdf

## SIFE

## FONTE

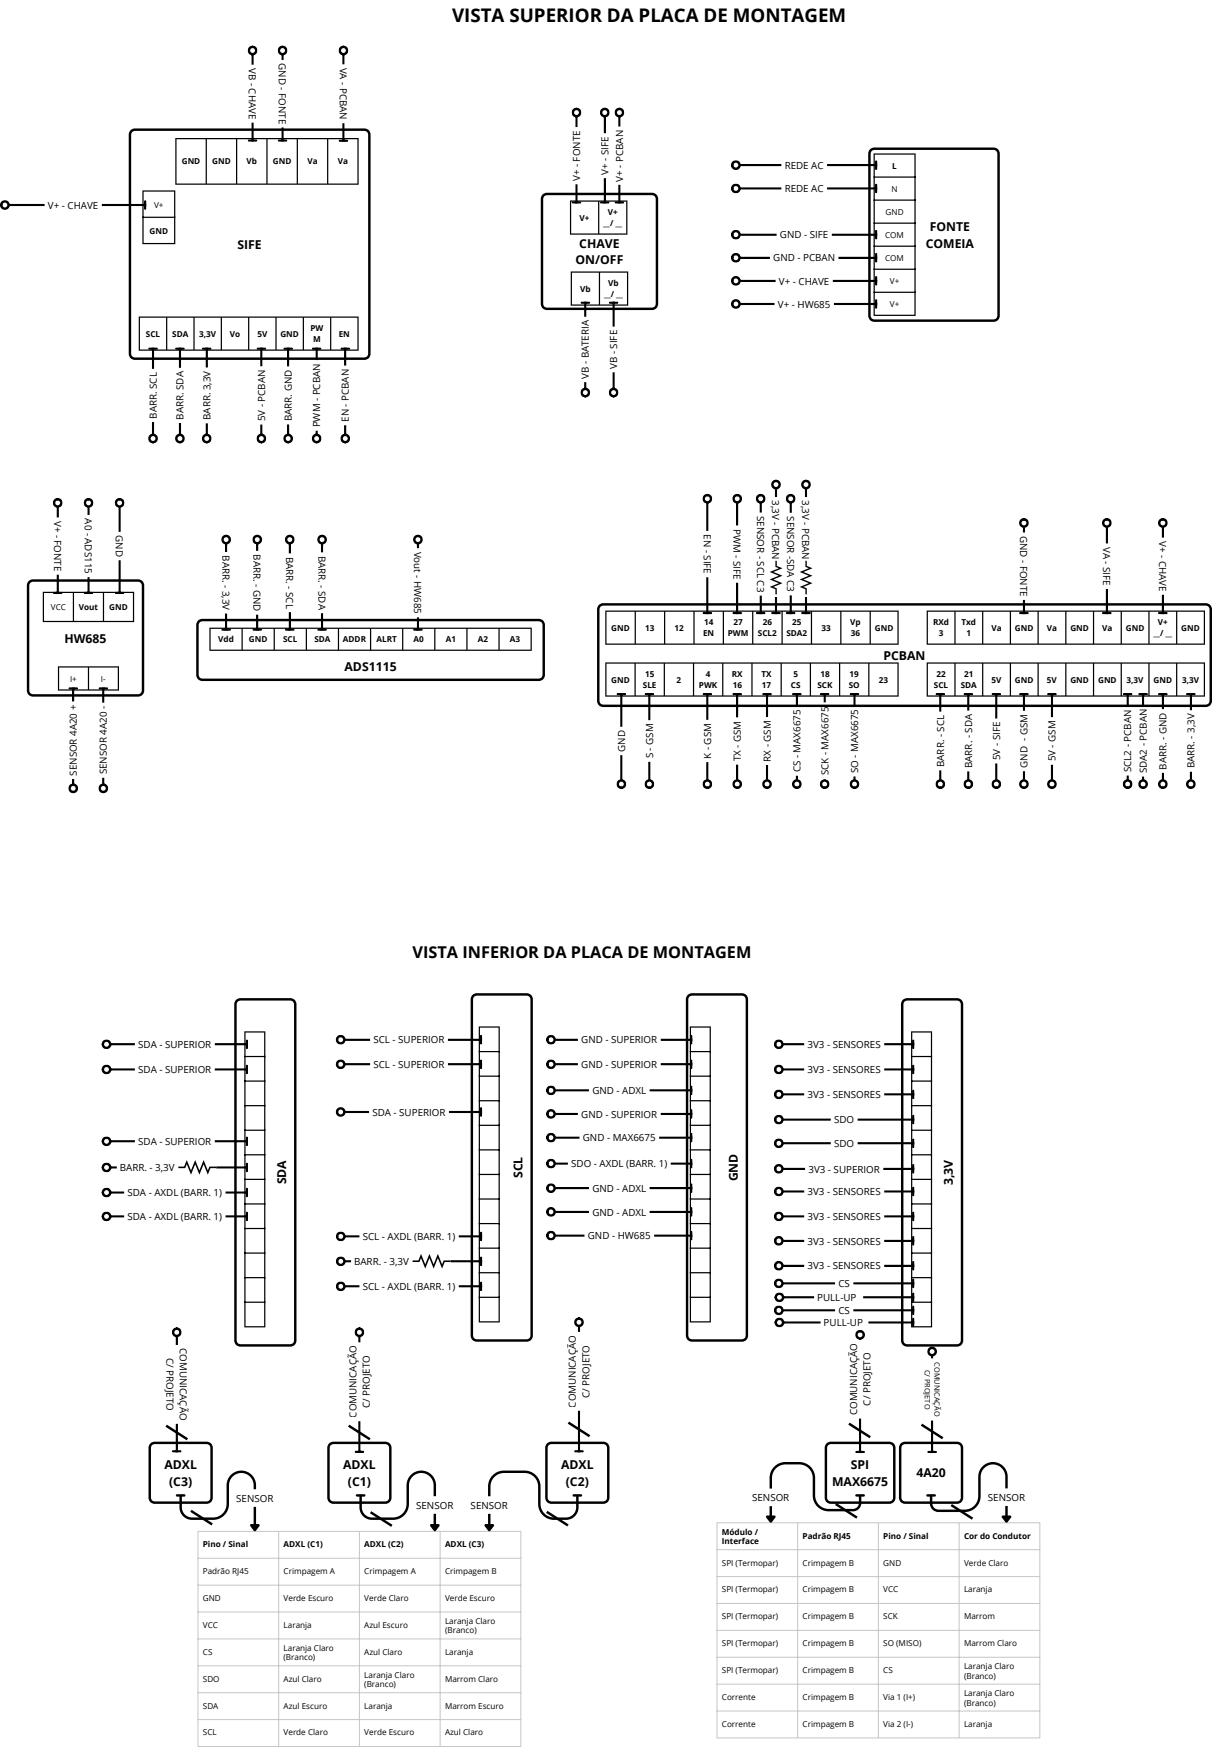
[picture p88: page 1]
VCC; Vout; GND V+ - FONTE; A0 - ADS115; GND; SENSOR 4A20 +; SENSOR 4A20 -; ADS1115; Vdd; SCL; SDA; ADDR; ALRT; A3 BARR. - 3,3V; BARR. - GND; BARR. - SCL; BARR. - SDA; Vout - HW685; GND - FONTE; VB - CHAVE; VA - PCBAN; V+ - CHAVE; BARR. SCL; BARR. SDA; BARR. 3,3V; 5V - PCBAN; BARR. GND; PWM - PCBAN; EN - PCBAN; COMEIA; COM; REDE AC; GND - SIFE; GND - PCBAN; CHAVE ON/OFF; VB - BATERIA; VB - SIFE; PCBAN; RXd 3; Txd 1; 27 PWM; 26 SCL2; 25 SDA2; 15 SLE; 4 PWK; 18 SCK; 22 SCL; 21 SDA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

VISTA SUPERIOR DA PLACA DE MONTAGEM

V+ - FONTE V+ - SIFE V+ - PCBAN

VISTA INFERIOR DA PLACA DE MONTAGEM

SDO - AXDL (BARR. 1)
GND - ADXL
GND - HW685

SDA - AXDL (BARR. 1)

SCL - AXDL (BARR. 1)

Módulo / Interface | Padrão RJ45 | Pino / Sinal | Cor do Condutor

Pino / Sinal | ADXL (C1) | ADXL (C2) | ADXL (C3)

SPI (Termopar) | Crimpagem B | GND | Verde Claro

Padrão RJ45 | Crimpagem A | Crimpagem A | Crimpagem B

SPI (Termopar) | Crimpagem B | VCC | Laranja

GND | Verde Escuro | Verde Claro | Verde Escuro

SPI (Termopar) | Crimpagem B | SCK | Marrom

VCC | Laranja | Azul Escuro | Laranja Claro (Branco)

CS | Laranja Claro (Branco) | Azul Claro | Laranja

SPI (Termopar) | Crimpagem B | SO (MISO) | Marrom Claro

SPI (Termopar) | Crimpagem B | CS | Laranja Claro (Branco)

SDO | Azul Claro | Laranja Claro (Branco) | Marrom Claro

Corrente | Crimpagem B | Via 1 (I+) | Laranja Claro (Branco)

SDA | Azul Escuro | Laranja | Marrom Escuro

Corrente | Crimpagem B | Via 2 (I-) | Laranja

SCL | Verde Claro | Verde Escuro | Azul Claro
