BernardoVilaca/LiteCOPASAelevatoria/Testes&Resultados/soc_plot_carga_descarga.pdf

80

90

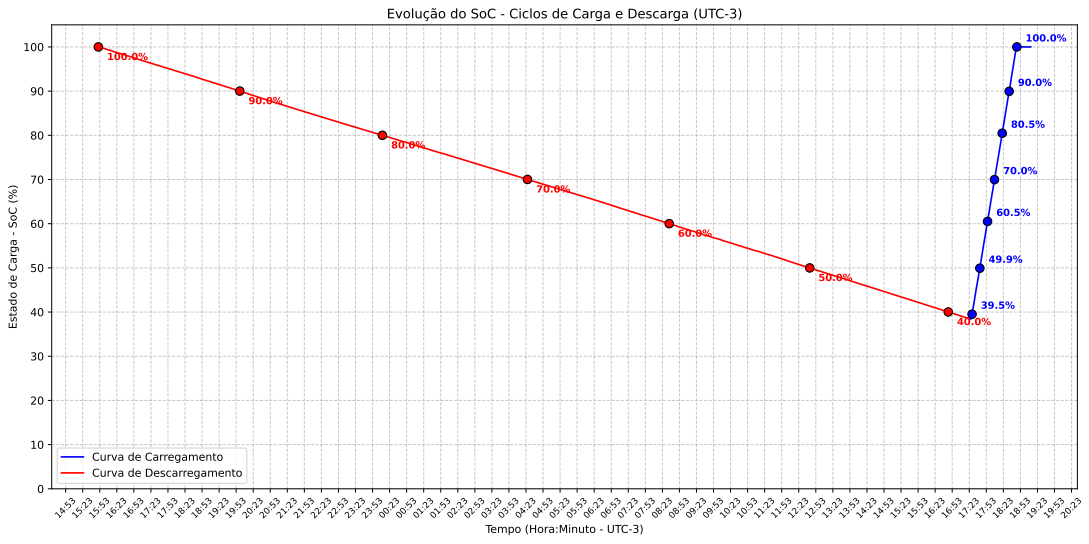
[picture p89: page 1]

Evolução do SoC - Ciclos de Carga e Descarga (UTC-3)

Estado de Carga - SoC (%)

Curva de Carregamento
Curva de Descarregamento

Tempo (Hora:Minuto - UTC-3)
