BernardoVilaca/LiteCOPASAelevatoria/principal/Connectar_Desconectar.h

#ifndef CONNECTAR_DESCONECTAR_H
#define CONNECTAR_DESCONECTAR_H

// Definições gerais *************************************************************************************************
#define NUM_AMOSTRAS            512     // Nº amostras transformada rápida de Fourier 
#define TAMANHO_BACKUP          64     // Nº backups
#define TINY_GSM_MODEM_A7670            // Modelo SIMGSM
#define BUFFER_MQTT_GSM         4096
#define KEEP_ALIVE_S            20      // Keep Alive para PINGREQ/PINGRESP
#define SOCKET_TIMEOUT_S        30      // Socket Timeout Broker MQTT

// Bibliotecas *************************************************************************************************
#include <Arduino.h>
#include <TinyGsmClient.h>
#include <PubSubClient.h>
#include <ArduinoJson.h>
#include <esp_task_wdt.h> 
#include "ESPEncrypt.h"
#include <driver/rtc_io.h>

// GSM - GPRS LTE *********************************************************************************************
const char apn[]      = "copasaiot.br"; 
const char gprsUser[] = "";
const char gprsPass[] = "";

#define SerialAT Serial1 
static TinyGsm modem(SerialAT);
static TinyGsmClient gsmClient(modem);
static PubSubClient client(gsmClient);
// Define os pinos do Modem ******************************************
#define MODEM_RX        16  
#define MODEM_TX        17  
#define MODEM_PWRKEY    4
#define MODEM_SLEEP     15         // Pino Sleep/DTR A7670 (controla UART sleep)
#define DTR_SET_SLEEP   0           // DTR LOW  -> modem pode dormir (CSCLK ativo)
#define DTR_SET_WAKE    1           // DTR HIGH -> acorda a UART do modem
#define MINUTES_FACTOR  6000
#define BAUD_RATE       115200
// Broker MQTT *************************************************************************************************
#define MQTT_SERVER "192.168.55.100" 
const int MQTT_PORT = 1884; 
const char* MQTT_USER = "ufmg";
const char* MQTT_PASSWORD = "Copasa,1";
static char mqttMsgBuffer[BUFFER_MQTT_GSM];
const int CHUNK_SIZE = 64;

// Tópicos MQTT *************************************************************************************************
#define TOPIC_VIBRA_S1_REAL   "sife_felipe/vibracao/sensor1/dados"
#define TOPIC_VIBRA_S2_REAL   "sife_felipe/vibracao/sensor2/dados"
#define TOPIC_VIBRA_S3_REAL   "sife_felipe/vibracao/sensor3/dados"
#define TOPIC_PRESSAO_REAL    "sife_felipe/pressao/dados"
#define TOPIC_TEMP_REAL       "sife_felipe/temperatura/dados"
#define TOPIC_ENERGIA_REAL    "sife_felipe/energia/dados"

#define TOPIC_VIBRA_S1_BACKUP "sife_felipe/vibracao/sensor1/backup"
#define TOPIC_VIBRA_S2_BACKUP "sife_felipe/vibracao/sensor2/backup"
#define TOPIC_VIBRA_S3_BACKUP "sife_felipe/vibracao/sensor3/backup"
#define TOPIC_PRESSAO_BACKUP  "sife_felipe/pressao/backup"
#define TOPIC_TEMP_BACKUP     "sife_felipe/temperatura/backup"
#define TOPIC_ENERGIA_BACKUP  "sife_felipe/energia/backup"

static StaticJsonDocument<512> jsonSmall;
static DynamicJsonDocument jsonLarge(BUFFER_MQTT_GSM);

typedef struct { int16_t x, y, z; } AmostraAcelerometro;

// Criptografia embarcada *************************************************************************************************
#define AES_KEY "6cc18720aed8cb60ceed9fb679495144"
ESPEncrypt crypto(AES_KEY);

int counterErrorTcp = 0;
int counterErrorModemInit = 0;
void waitingTime(const int wait_ms);
/*******************************************************************************************************************************/
bool sleepModem()
{
    Serial.print("[MODEM] Entrando em sleep (CSCLK + DTR): ");

    modem.sendAT("+CSCLK=1");
    if (modem.waitResponse(2000L) != 1) {
        Serial.println("CSCLK=1 sem confirmação AT — forçando DTR LOW.");
    } else {
        Serial.println("OK");
    }

    // Garante que o pino vai para 0V mesmo se a UART não tiver respondido
    digitalWrite(MODEM_SLEEP, DTR_SET_SLEEP);
    waitingTime(100);
    rtc_gpio_hold_en((gpio_num_t)MODEM_SLEEP);

    return true;
}

bool wakeModem()
{
    Serial.print("[MODEM] Acordando (DTR wake): ");

    rtc_gpio_hold_dis((gpio_num_t)MODEM_SLEEP);

    digitalWrite(MODEM_SLEEP, DTR_SET_WAKE);
    waitingTime(300); // Tempo aumentado de 50ms para 300ms para estabilizar a UART

    while (SerialAT.available()) SerialAT.read();

    if (modem.testAT(3000)) {
        modem.sendAT("+CSCLK=0");
        modem.waitResponse(1000L);
        
        modem.sendAT("+CFUN=1");
        modem.waitResponse(5000L);
        
        Serial.println("OK");
        return true;
    }

    Serial.println("sem resposta (pode estar desligado).");
    return false;
}

bool offModem()
{
    wakeModem();
    modem.gprsDisconnect();

    // Desliga apenas o rádio RF (CFUN=0) em vez de desligar o chip (CPOF)
    modem.sendAT("+CFUN=0");      
    if (modem.waitResponse(5000L) == 1) {
        Serial.println("[MODEM] Radio RF desligado (CFUN=0).");
    } else {
        Serial.println("[OFF MODEM] AT+CFUN=0 sem resposta.");
    }

    return sleepModem();
}

// Envia Comandos AT *************************************************************************************************
void sendATCommand(String cmd) {
  Serial.print("Enviando: ");
  Serial.println(cmd);
  
  modem.sendAT(cmd); 
  
  String response = "";
  if (modem.waitResponse(2000L, response) == 1) { 
    Serial.print("Resposta: ");
    Serial.println(response);
  } else {
    Serial.println("Sem resposta ou erro!");
  }
}
// Liga o modem **********************************************************************************************************
bool powerModem() {
    Serial.println("Testing AT... ");
  if (!modem.testAT()) {
    Serial.println("Failed to connect to modem");
  } else {
    Serial.println("Modem is responding!");
    return true;
  }

    digitalWrite(MODEM_PWRKEY, LOW);
    waitingTime(1500); 
    digitalWrite(MODEM_PWRKEY, HIGH);
    
    waitingTime(5000);
    while(SerialAT.available()) SerialAT.read();
    return true;
}

// Espera com watchdog **********************************************************************************************************
void waitingTime(const int wait_ms) 
{
esp_task_wdt_reset();
uint32_t start = millis();
while ((uint32_t)(millis() - start) < wait_ms) {
    client.loop();
    yield();  
}
}

/*******************************************************************************************************************************/
bool checkIP() 
{
    String ip = modem.getLocalIP();
    if(ip == "" || ip == "0.0.0.0") {
        Serial.print("  -> [REDE] ERRO: IP Invalido: ");
        Serial.println(ip);
        return false;
    }
    return true;
}

/*******************************************************************************************************************************/
bool conectarRedeEbroker() 
{
   esp_task_wdt_reset(); 
    Serial.println("  -> [REDE] Ligando a interface do chip 4G...");

    if (!wakeModem()) {
        powerModem();
        SerialAT.println("AT");
        waitingTime(3000);
    }
    
    if (!modem.init()) {
        Serial.println("  -> [REDE] ERRO: O modem nao respondeu.");
        
        counterErrorModemInit++; 
        Serial.printf("[MODEM] Tentativa de inicializacao %d de 3 falhou.\n", counterErrorModemInit);
        
        if (counterErrorModemInit >= 3) {
            Serial.println("[CRÍTICO] Falha no modem 3 vezes seguidas. Reiniciando o ESP32...");
            waitingTime(2000); 
            ESP.restart();
        }
        return false;
    }

    counterErrorModemInit = 0;

    if (!modem.setNetworkMode((NetworkMode)38)) {
        Serial.println("  -> [REDE] ERRO: Não foi setado Network mode corretamente");
    }

    Serial.println("  -> [REDE] Buscando sinal da operadora...");
    esp_task_wdt_reset();
    if (!modem.waitForNetwork(60000L)) {
        Serial.println("  -> [REDE] ERRO: Antena nao encontrada.");
        return false;
    }
    
    Serial.println("  -> [REDE] Autenticando (GPRS)...");
    esp_task_wdt_reset();
    if (!modem.gprsConnect(apn, gprsUser, gprsPass)) {
        Serial.println("  -> [REDE] ERRO: Falha ao estabelecer dados moveis.");
        return false;
    }
    
    client.setServer(MQTT_SERVER, MQTT_PORT);
    client.setBufferSize(BUFFER_MQTT_GSM);
    client.setKeepAlive(KEEP_ALIVE_S);
    client.setSocketTimeout(SOCKET_TIMEOUT_S);

    String clientId = "SIFE_PLANTA_" + String(esp_random(), HEX);

    Serial.println("  -> [REDE] Conectando ao Servidor MQTT na nuvem...");
    
    int mqttRetries = 0;
    while (mqttRetries < 3) {
        esp_task_wdt_reset();
        if (client.connect(clientId.c_str(), MQTT_USER, MQTT_PASSWORD)) {
            Serial.println("  -> [REDE] SUCESSO! Link com o servidor estabelecido.");
            return true;
        } else {
            Serial.printf("  -> [REDE] Erro MQTT (Tentativa %d de 3). Codigo: %i\n", mqttRetries + 1, client.state());
            mqttRetries++;
            unsigned long waitTime = millis();
            while(millis() - waitTime < 2000) { esp_task_wdt_reset(); waitingTime(10); }
        }
    }

    if(client.state() == -2) {
        counterErrorTcp++;
    }
    if(counterErrorTcp >= 2) {
        Serial.println("[MODEM] Reiniciando Modem (contador de falhas -2 >= 2)");
        modem.restart();            
        counterErrorTcp = 0;
        return false;
    }
    
    return false;
}
/*******************************************************************************************************************************/
void desconectarRede() 
{
    if (client.connected()) client.disconnect();
    sleepModem();   
    Serial.println("  -> [REDE] Modem em sleep.");
}

/*******************************************************************************************************************************/
// Atualizado com o Novo Padrão (Unified Namespace) para os arrays de vibração
void getVibracao(const int sensorID, AmostraAcelerometro* bufferRaw, String outJsons[], const char* tipoMensagem)
{
    for (int parte = 0; parte < NUM_AMOSTRAS / CHUNK_SIZE; parte++)
    {
        esp_task_wdt_reset(); 
        jsonLarge.clear();
        jsonLarge["tipo"] = tipoMensagem; 
        jsonLarge["s"] = sensorID;
        jsonLarge["p"] = parte + 1;

        JsonArray dataX = jsonLarge.createNestedArray("amostras_x");
        JsonArray dataY = jsonLarge.createNestedArray("amostras_y");
        JsonArray dataZ = jsonLarge.createNestedArray("amostras_z");
        
        for (int i = parte * CHUNK_SIZE; i < (parte * CHUNK_SIZE) + CHUNK_SIZE; i++) {
            dataX.add(bufferRaw[i].x);
            dataY.add(bufferRaw[i].y);
            dataZ.add(bufferRaw[i].z);
        }
        String jsonString;
        serializeJson(jsonLarge, jsonString);
        String cipher = crypto.encryptString(jsonString);
        outJsons[parte] = cipher;
    }
}

/******************************************************************************************************************/
bool enviarDadosAcelerometro(int sensorId, AmostraAcelerometro *buffer, const char* topic, const char* tipoMensagem) {
  String jsonsVibracaoTemp[NUM_AMOSTRAS/CHUNK_SIZE];
  
  getVibracao(sensorId, buffer, jsonsVibracaoTemp, tipoMensagem);
  
  bool sucessoTotal = true;

  for (int i = 0; i < NUM_AMOSTRAS/CHUNK_SIZE; i++) {
    esp_task_wdt_reset(); 
    
    if( !client.publish(topic, jsonsVibracaoTemp[i].c_str()) ) {
      sucessoTotal = false; 
      Serial.println("-> Erro TCP/MQTT detectado no chunk. Abortando sensor.");
    }
    
    waitingTime(500); 
  }

  return sucessoTotal;
}

/********************************************************************************************************/
String getMedida(float medida, const char* tipoMensagem)
{
    jsonSmall.clear();
    jsonSmall["tipo"] = tipoMensagem;
    jsonSmall["val"] = medida;
    String jsonString;
    serializeJson(jsonSmall, jsonString);
    String cipher = crypto.encryptString(jsonString);
    return cipher;
}

/************************************************************************************************************************ */
// Atualizado com o Novo Padrão (Unified Namespace) para o payload de energia
String getEnergiaSife(float v_f, float v_b, float i_b, float s, int r, bool e1, bool e2, const char* tipoMensagem)
{
    jsonSmall.clear();
    jsonSmall["tipo"] = tipoMensagem; 
    jsonSmall["tensao_fonte"] = v_f;
    jsonSmall["tensao_bateria"] = v_b;
    jsonSmall["I_Bat"] = i_b; 
    jsonSmall["estado_carga_bateria"] = s;
    jsonSmall["rede_corrente_alternada"] = r;
    jsonSmall["erro_sensor_ina_1"] = e1; 
    jsonSmall["erro_sensor_ina_2"] = e2;
    String jsonString;
    serializeJson(jsonSmall, jsonString);
    String cipher = crypto.encryptString(jsonString);
    return cipher;
}
#endif
