BernardoVilaca/LiteCOPASAelevatoria/(commit log)

2026-04-08 Add files via upload
    Testes de comunicação on-board à longa distância
2026-04-08 Add files via upload
    Visita técnica à planta de instalação (Como construído do projeto)
2026-04-08 Add files via upload
    Estudos e relatório sobre o circuito conversor de corrente (em sinal 4a20mA) para tensão (0a3V3)
2026-04-24 Adição de criptografia (excetuando o acelerometro)
2026-09-25 Update MOS_PIM and PWM_PIN definitions
2026-09-29 Enhance sensor calibration and data collection
    Updated sensor calibration and collection functions to apply dynamic offsets and gains for three accelerometer sensors. Adjusted temperature reading and optimized I2C memory management.
2026-09-29 Refactor modem control and data handling functions
    Updated modem sleep and wake functions, improved JSON structure for vibration and energy data, and refined error handling for MQTT connections.
    [Connectar_Desconectar.h]
2026-09-29 Refactor backup handling for unified namespace
    Updated backup functions to use 'contingencia' instead of 'BACKUP' for JSON types and changed array names for accelerometer samples.
2026-09-29 Change 'REALTIME' to 'tempo_real' in data handling
    Updated the namespace for pressure, temperature, and accelerometer data to 'tempo_real' for consistency.
2026-09-30 Modify shunt resistor values and INA219 setup
    Updated shunt resistor values and removed INA219 calibration calls.
2026-10-27 Enable GPIO deep sleep hold in SIFE_LIB.h
    Added gpio_deep_sleep_hold_en() to maintain pin states during deep sleep.
2026-10-28 Add initialization checks for accel3 sensor
